Rinuys/MicroprocessorProject/최종발표_컴퓨터과학부_2014920044_이홍석.pptx

미세먼지 센서를 이용한 소형 공기청정기

1. 기능
  1. 미세먼지 센서를 통해 미세먼지 농도를 측정
  2. 측정된 미세먼지 농도 출력
  3. 미세먼지 농도에 따른 팬 속도 자동 조절
  4. 팬 On/Off 기능


2. 시나리오
  1. USB를 보조배터리에 꽂는다.
  2. 화면에 Initializing…이 출력되고 30초 뒤에 출력
  3. 매 30초 마다 측정된 미세먼지 농도 출력
  4. 기기 왼쪽에 있는 스위치를 키면 팬 On
  5. 농도에 따라 팬 속도 자동 조절
  6. 스위치를 끄면 팬 Off
