Rinuys/MicroprocessorProject/중간발표_컴퓨터과학부_2014920044_이홍석.pptx

## 자동 공기청정기

컴퓨터과학부 2014920044 이홍석

## 구현계획

- 현재 장소의 미세먼지 농도를 측정한다.
- 현재 미세먼지의 농도를 LCD 를 통해 알려준다.
- 필터를 장착하여 미세먼지를 걸러준다.
- 미세먼지 농도가 높을수록 모터의 속도를 높인다.

## 주요부품

- 미세먼지 측정센서
- 모터
- 방진필터
- LCD
- 저항
- 선

## 예시

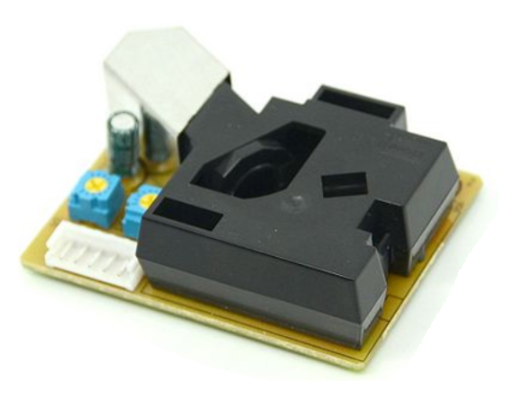
[picture p9: figure]

미세먼지 센서

JKIT-128-1

필터

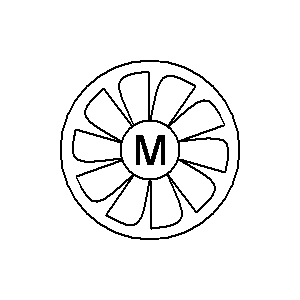
[picture p10: figure]
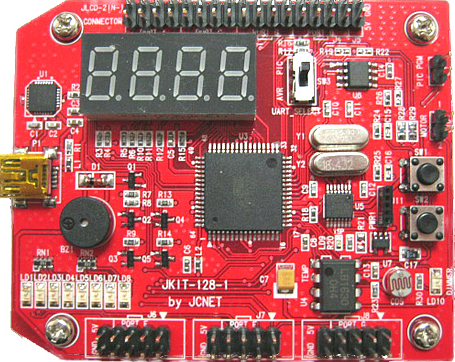
[picture p11: figure]

외부 전원

모터

LCD

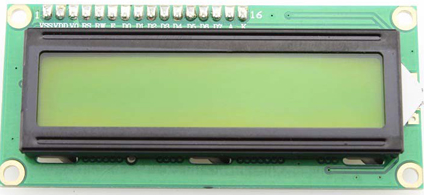
[picture p12: figure]
