Rinuys/MicroprocessorProject/(commit log)

2018-11-07 중간발표ppt
2018-11-14 견적+제안서
